Jknaebel68/Extruder/Dokumentation/Pinout_Sparkfun_Pro_Micro.jpg

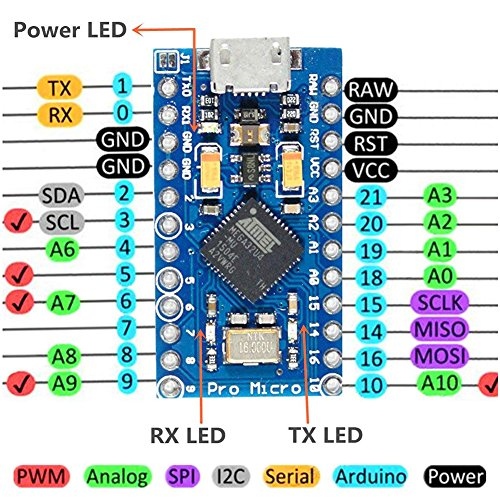
Dokumentation/Pinout_Sparkfun_Pro_Micro.jpg
