Jknaebel68/Extruder/Bilder/IMG_20191024_204414.jpg

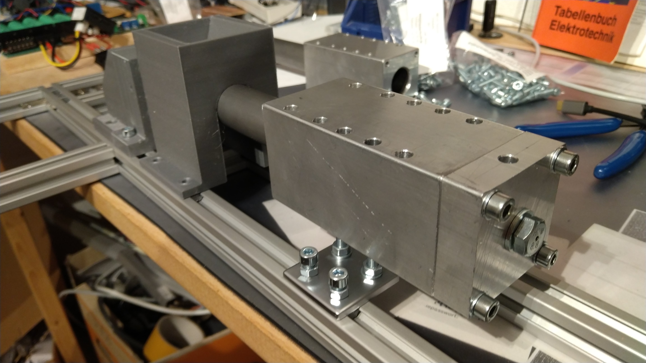
Bilder/IMG_20191024_204414.jpg
