Jknaebel68/Extruder/Steuerungsprogramm(e)/Zugmotor/Release Info Zugmotor.txt

Release Informationen zu "Zugmotorsteuerung.ino"

---------------------------------------------------------------------

v0.1
03.01.2020

Steuerung des Zugmotors über i2c
Der Zugmotor zieht am Filament um dies aus dem Extruder zu befördern.
Desweiteren kann über die Geschwindigkeitsänderung die Dicke des Filaments beeinflusst werden.
Ist der Vorschub des Zugmotors kleiner als die Extrusion, wird das Filament dicker.
Ist der Vorschub des Zugmotors größer als die Extrusion, wird das Filamend dünner.
Die Maßeinheit für den Vorschub wird in mm/min angegeben und in der Steuerung entsprechend auf die Schritte/min umgerechnet.

---------------------------------------------------------------------
