Jknaebel68/Extruder/Bilder/Bild Extruder Stand neue Kühlung 191005.jpg

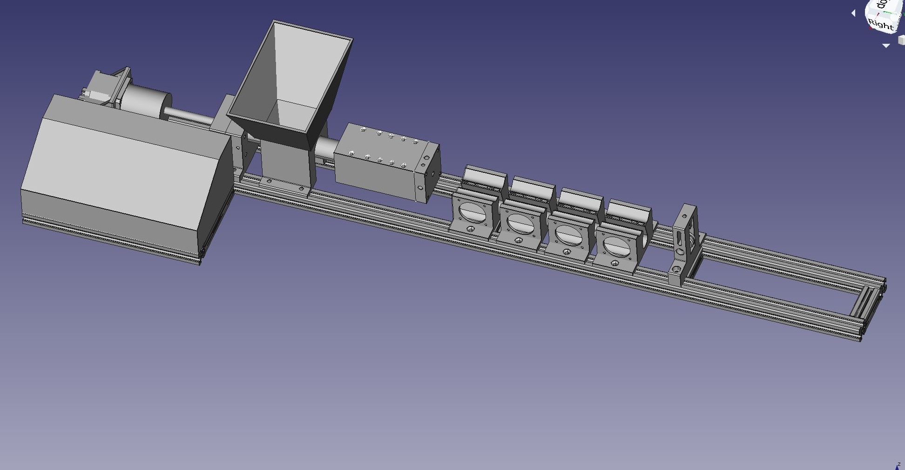
Bilder/Bild Extruder Stand neue Kühlung 191005.jpg
