Jknaebel68/Extruder/Bilder/IMG_20191008_212313.jpg

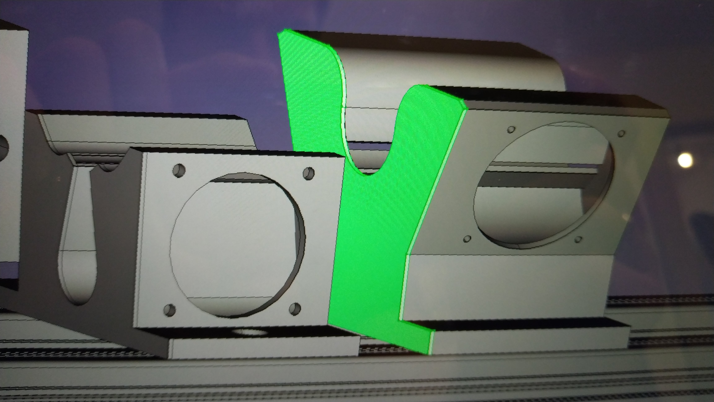
Bilder/IMG_20191008_212313.jpg
