Jknaebel68/Extruder/Bilder/IMG_20191024_204409.jpg

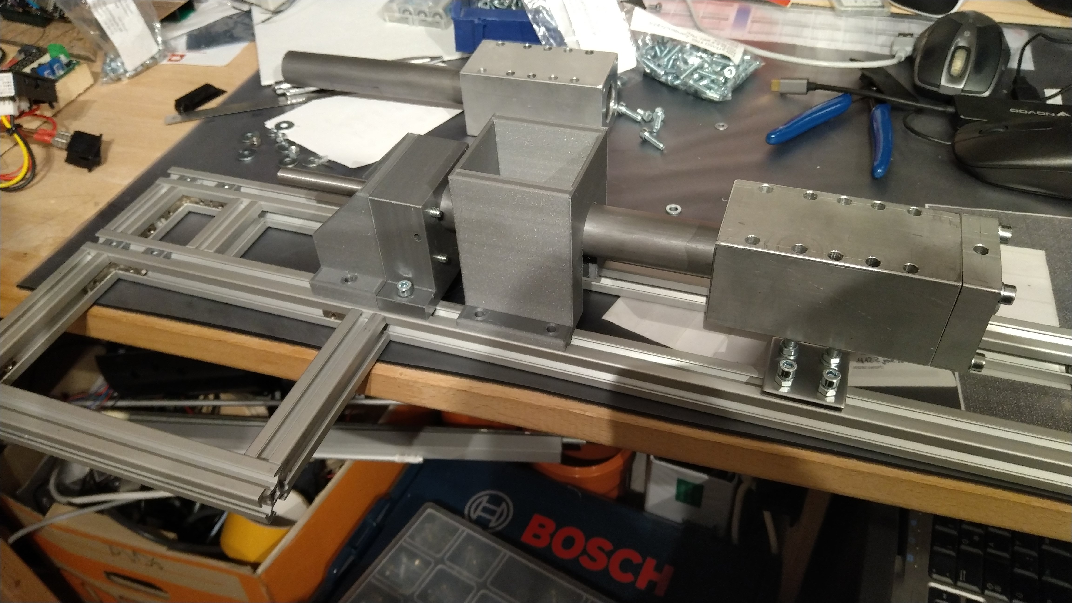
Bilder/IMG_20191024_204409.jpg
