Jknaebel68/Extruder/Bilder/IMG_20191024_204424.jpg

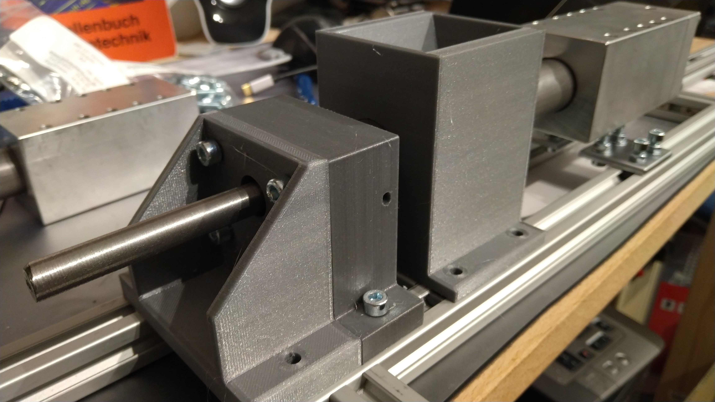
Bilder/IMG_20191024_204424.jpg
