Jknaebel68/Extruder/Bilder/IMG_20191024_204436.jpg

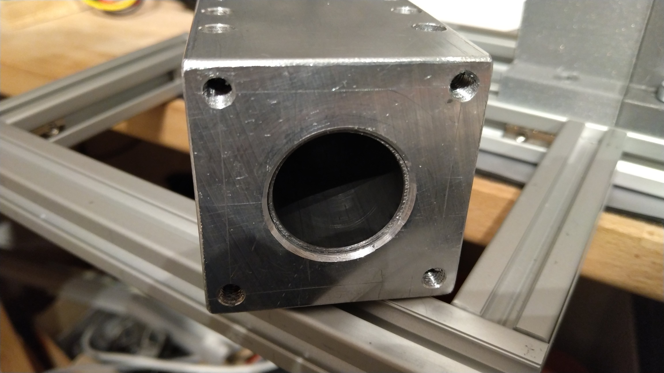
Bilder/IMG_20191024_204436.jpg
