Jknaebel68/Extruder/Bilder/IMG_20191024_204439.jpg

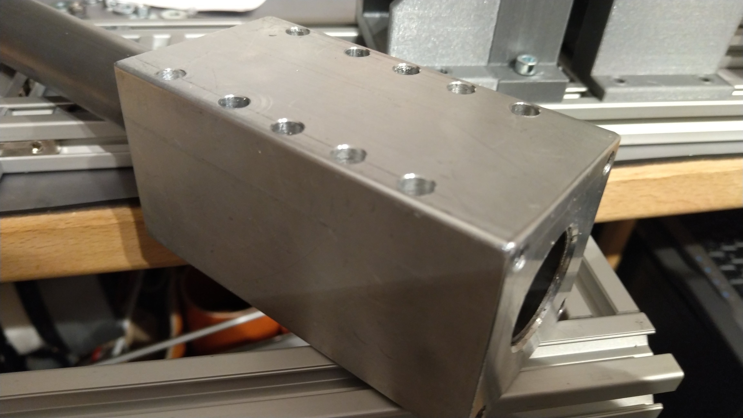
Bilder/IMG_20191024_204439.jpg
