Jknaebel68/Extruder/Bilder/IMG_20191102_174123.jpg

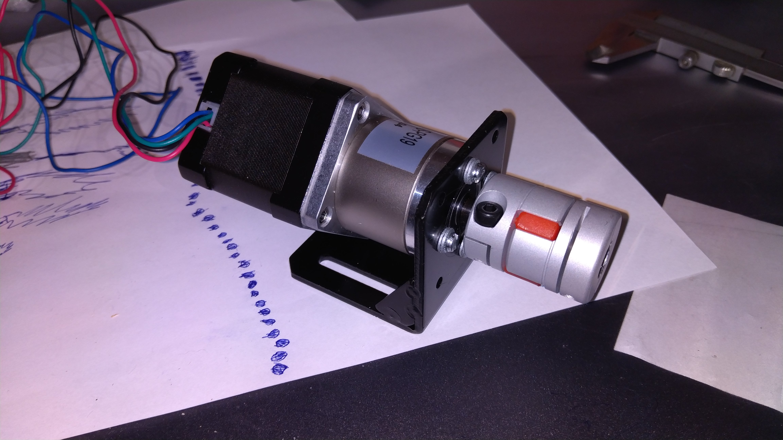
Bilder/IMG_20191102_174123.jpg
