Jknaebel68/Extruder/Bilder/IMG_20191102_174132.jpg

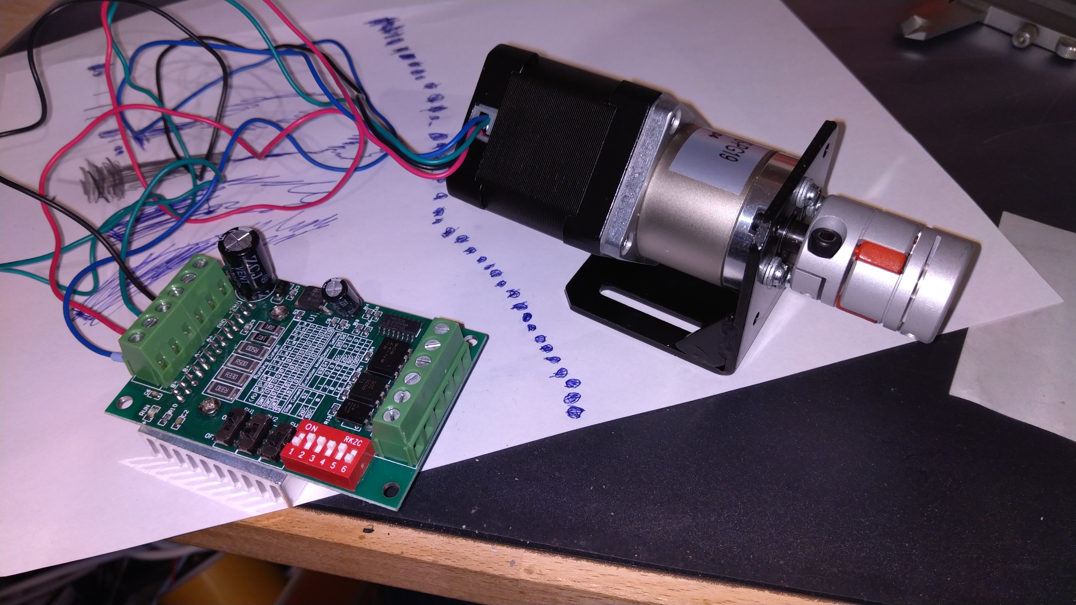
Bilder/IMG_20191102_174132.jpg
