Jknaebel68/Extruder/Dokumentation/Pinout_Arduino_Mega.png

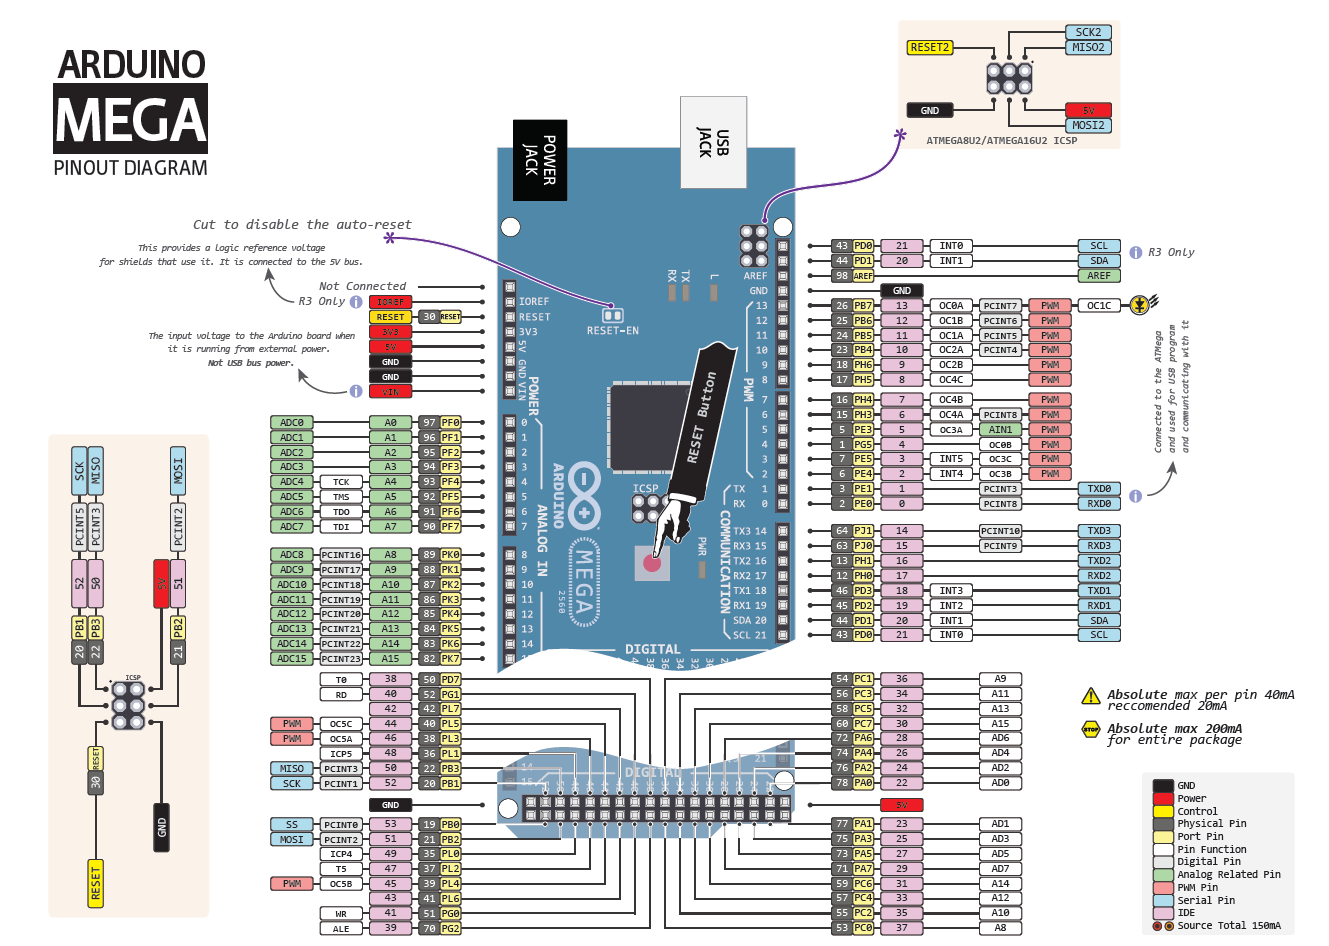
Dokumentation/Pinout_Arduino_Mega.png
