Jknaebel68/Extruder/Freecad/Distanzmotorgetriebe.stl

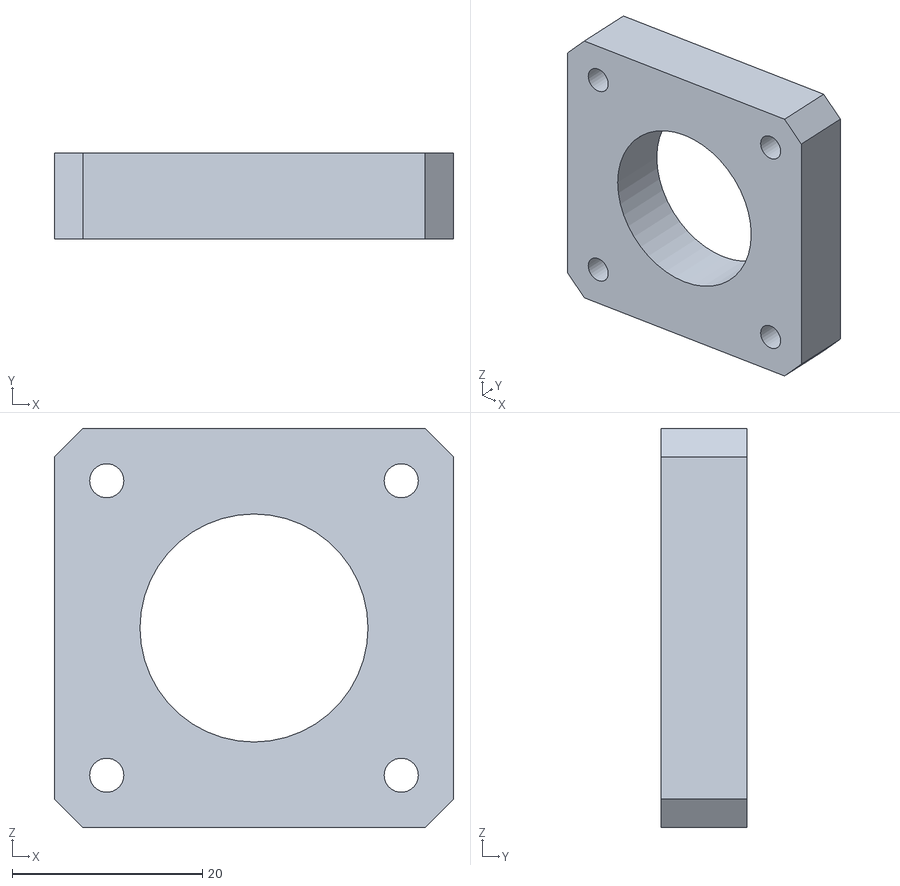
[picture p13: CAD file, 2019-12-24]
Freecad/Distanzmotorgetriebe.stl
42.0 x 9.00 x 42.0
