Jknaebel68/Extruder/Freecad/Zugeinheit.stl

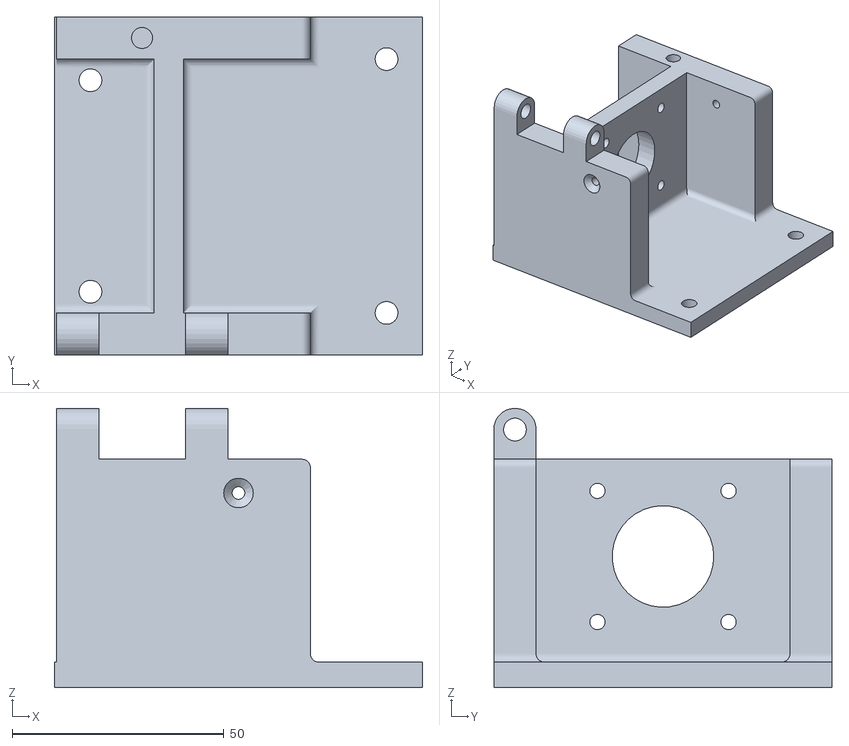
[picture p14: CAD file, 2019-12-24]
Freecad/Zugeinheit.stl
87.0 x 80.0 x 66.0
