Jknaebel68/Extruder/Freecad/Klemmhebel.stl

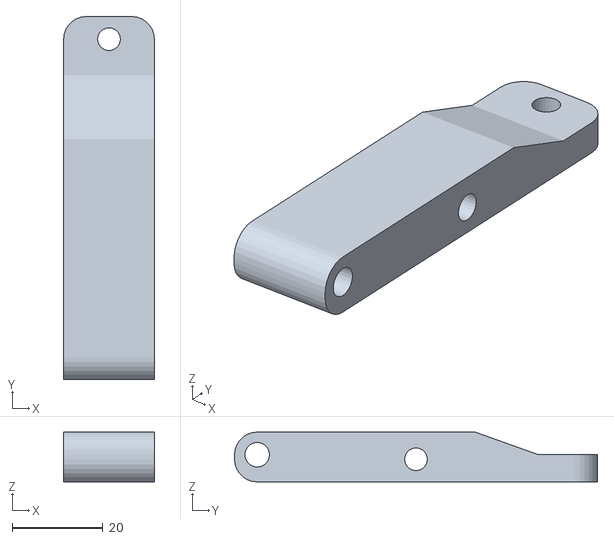
[picture p15: CAD file, 2019-12-24]
Freecad/Klemmhebel.stl
20.0 x 80.0 x 11.0
