Jknaebel68/Extruder/Freecad/Sensorhalter.stl

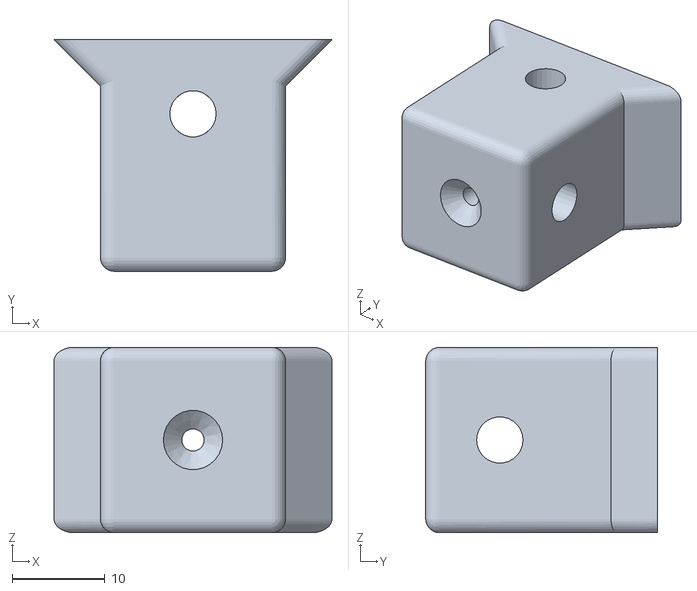
[picture p16: CAD file, 2019-12-24]
Freecad/Sensorhalter.stl
30.0 x 25.0 x 20.0
