Jknaebel68/Extruder/Freecad/Zugrolle.stl

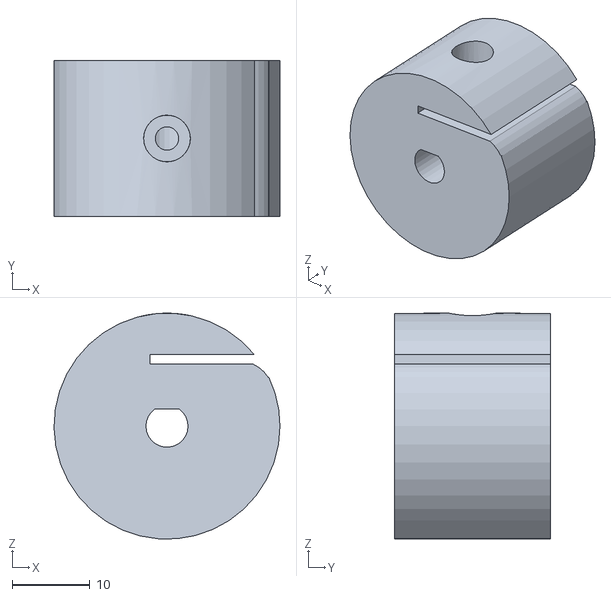
[picture p17: CAD file, 2019-12-24]
Freecad/Zugrolle.stl
29.0 x 20.0 x 29.0
