Jknaebel68/Extruder/Freecad/Anpressrolle.stl

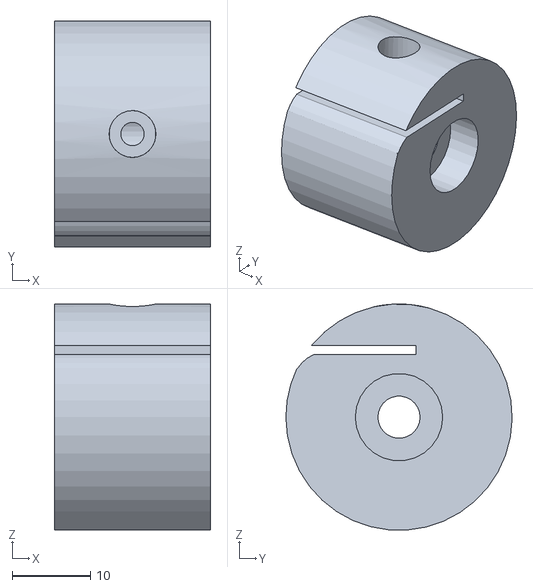
[picture p18: CAD file, 2019-12-24]
Freecad/Anpressrolle.stl
20.0 x 29.0 x 29.0
