Jknaebel68/Extruder/Freecad/Anpressschlitten.stl

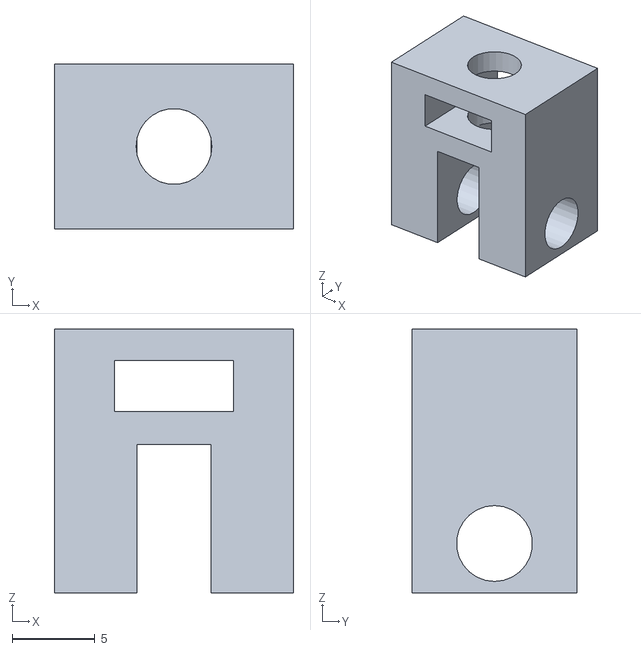
[picture p19: CAD file, 2019-12-24]
Freecad/Anpressschlitten.stl
14.5 x 10.0 x 16.0
