Jknaebel68/Extruder/Freecad/ExtrudereinheitV2git.FCStd

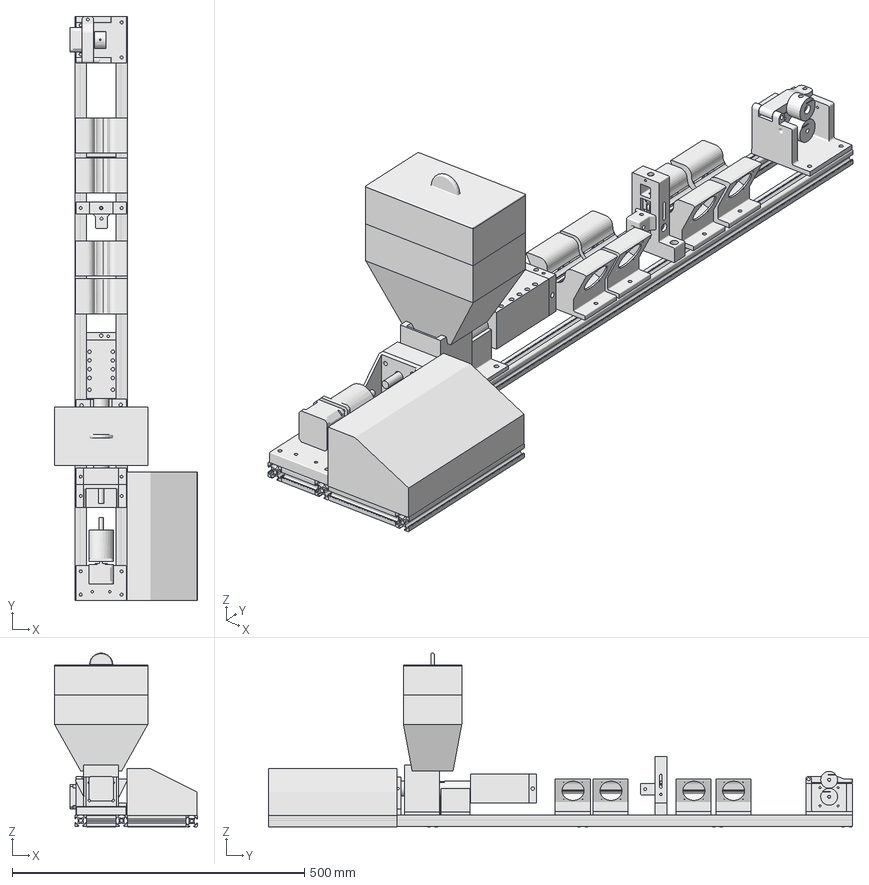
[picture p20: CAD file, 2019-12-24]
Freecad/ExtrudereinheitV2git.FCStd
245.0 x 1000.0 x 297.4 mm
Extrudermantel
Düsenplatte
Heizblock
Axiallager
Einfüllstutzen
Vorratsbehälter
Extruderschnecke
Aluprofil20x20x50_1
Aluprofil20x20x50_002
Aluprofil20x20x50_003
Aluprofil20x20x50_004
Aluprofil20x20x50_005
Getriebe
Kugellagerbock
Führungsbock
Anpressschlitten
Filamentführung
Anpresslager
P20_N6_B002
Aluprofil20x20x50_006
P20_N6_B001
Aluprofil20x20x101
Aluprofil20x20x102
Aluprofil20x20x103
Kühlelement1
Kühlelement002
Kühlelement003
Kühlelement004
Motorsockel
ErweiterungVorrat001
ErweiterungVorrat002
Deckel
Mantelhalter001
Mantelhalter002
Zugeinheit
Klemmhebel
Sensorhalter
Zugrolle
Zugrolle001
Motor_NEMA17
Motor_NEMA018
