Jknaebel68/Extruder/Freecad/Lagerabdeckstütze.stl

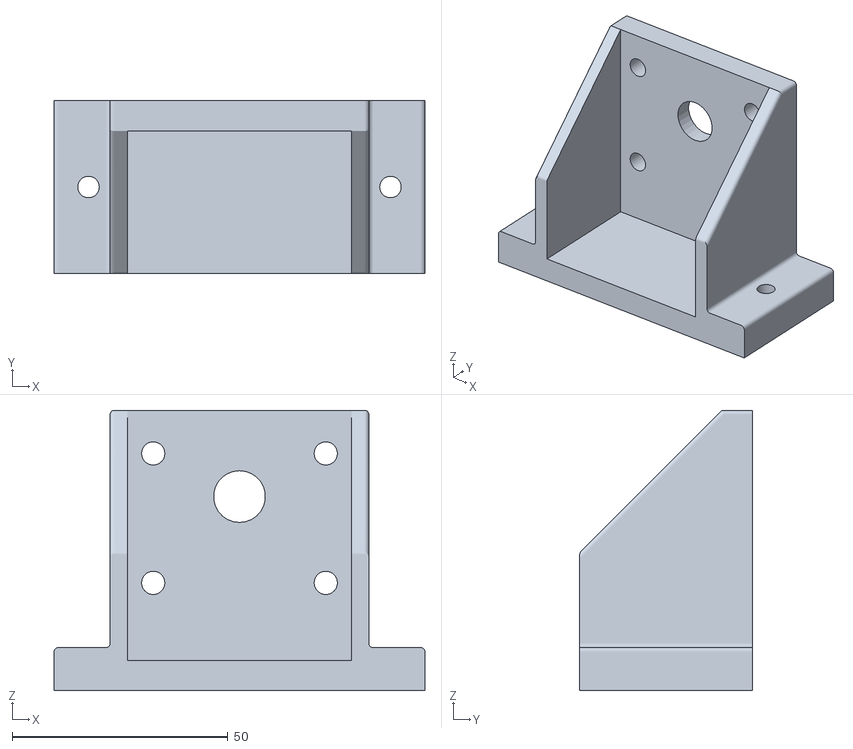
[picture p21: CAD file, 2019-12-01]
Freecad/Lagerabdeckstütze.stl
86.0 x 40.0 x 65.0
