Jknaebel68/Extruder/Freecad/Motorsockel.stl

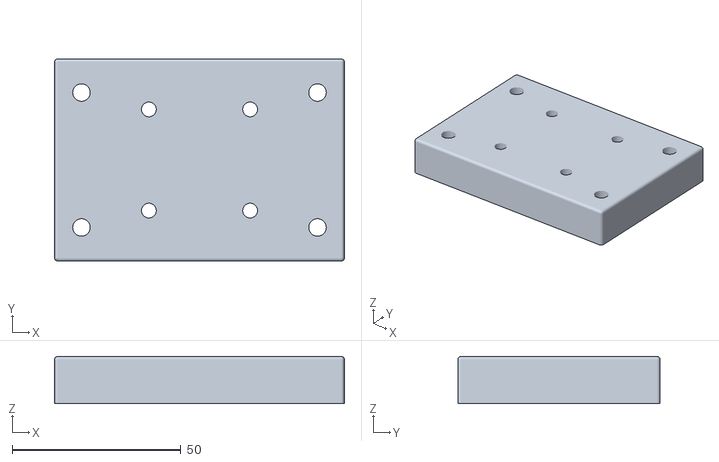
[picture p22: CAD file, 2019-12-01]
Freecad/Motorsockel.stl
86.0 x 60.0 x 14.0
