Jknaebel68/Extruder/Freecad/Einfuellstutzen.stl

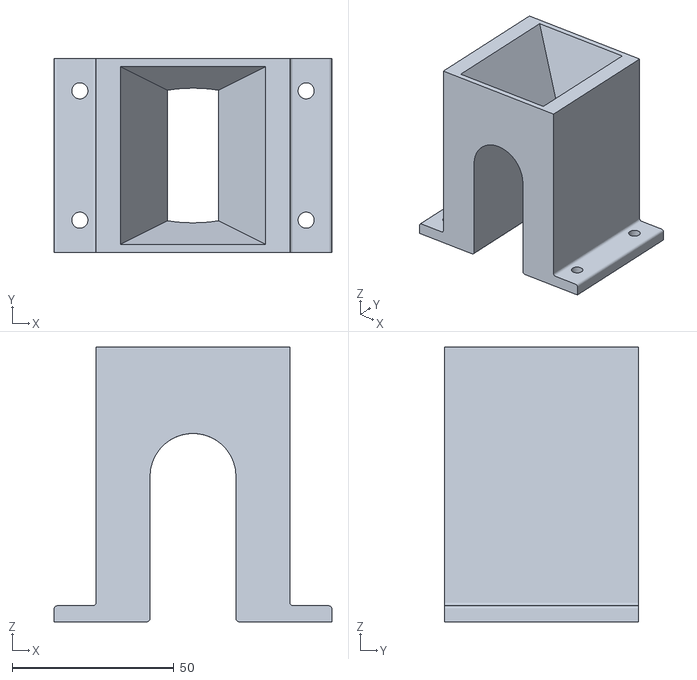
[picture p23: CAD file, 2019-12-01]
Freecad/Einfuellstutzen.stl
86.0 x 60.0 x 85.0
