Jknaebel68/Extruder/Freecad/Vorratsbehälter.stl

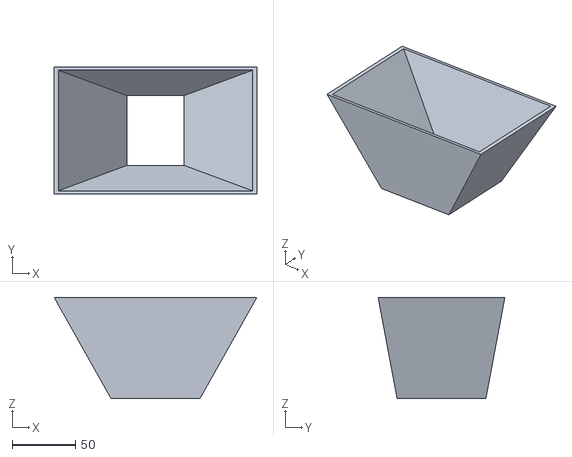
[picture p24: CAD file, 2019-12-01]
Freecad/Vorratsbehälter.stl
160.0 x 100.0 x 80.0
