Jknaebel68/Extruder/Freecad/Kühlstrecke2v2.stl

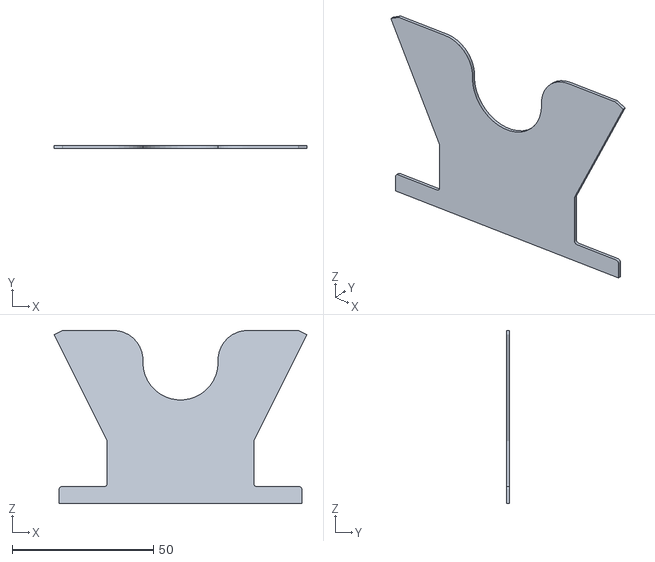
[picture p25: CAD file, 2019-12-01]
Freecad/Kühlstrecke2v2.stl
89.6 x 1.00 x 61.3
