Jknaebel68/Extruder/Freecad/ErweiterungVorrat.stl

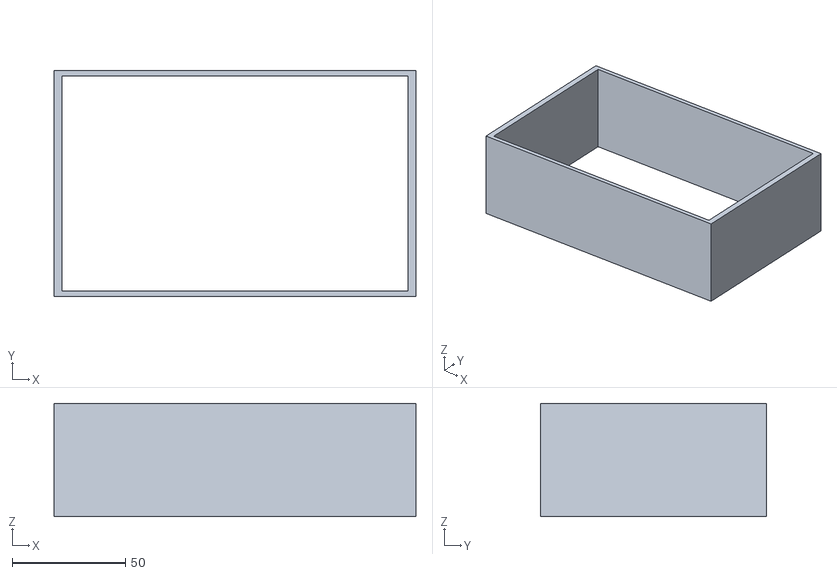
[picture p26: CAD file, 2019-12-01]
Freecad/ErweiterungVorrat.stl
160.0 x 100.0 x 50.0
