Jknaebel68/Extruder/Freecad/Kühlstrecke1v2.stl

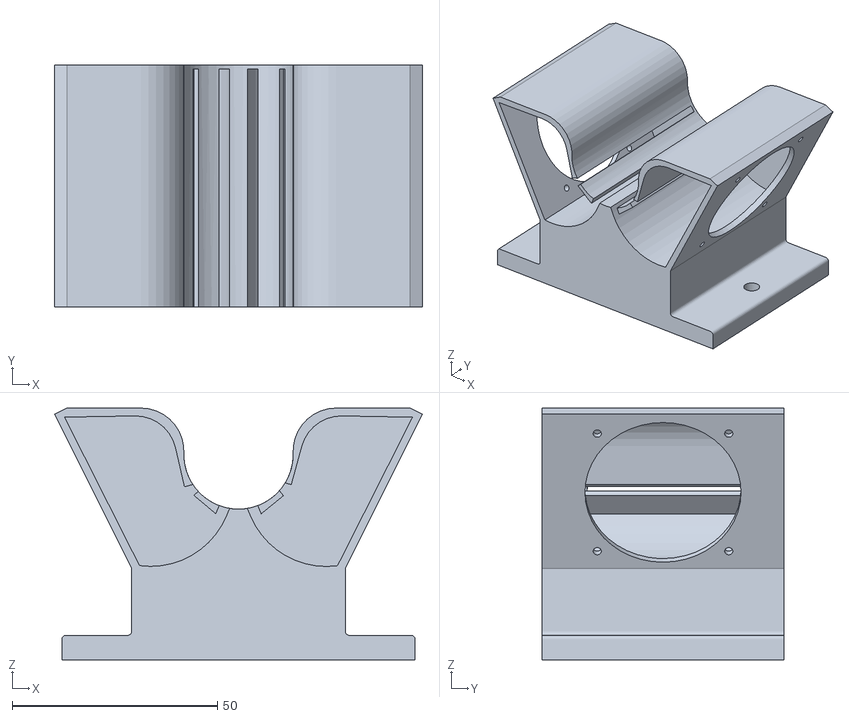
[picture p27: CAD file, 2019-12-01]
Freecad/Kühlstrecke1v2.stl
89.6 x 59.0 x 61.3
