Jknaebel68/Extruder/Freecad/Deckel.stl

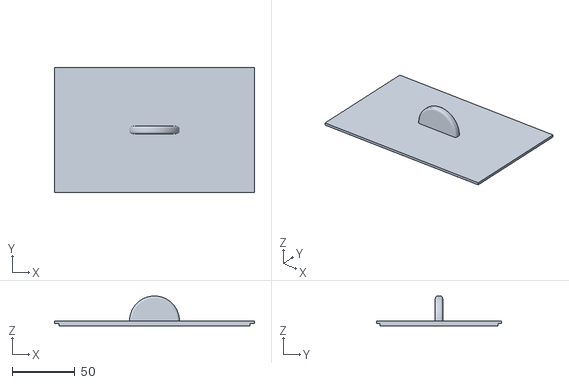
[picture p28: CAD file, 2019-12-01]
Freecad/Deckel.stl
160.0 x 100.0 x 24.0
