Jknaebel68/Extruder/Freecad/Schrägsitzlagerbock.stl

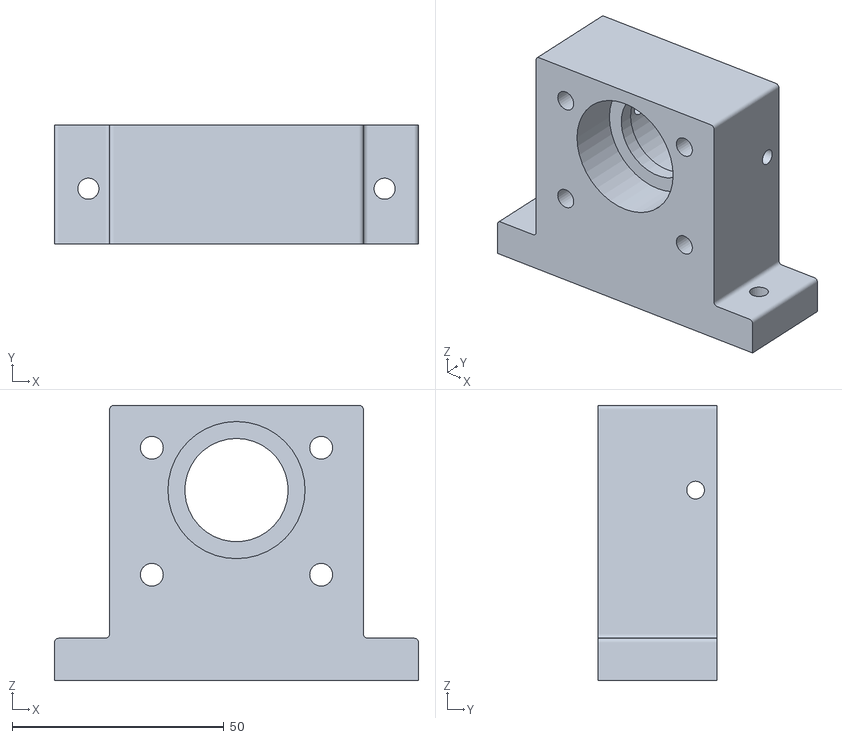
[picture p29: CAD file, 2019-12-01]
Freecad/Schrägsitzlagerbock.stl
86.0 x 28.0 x 65.0
