Jknaebel68/Extruder/Dokumentation/Datenblatt_Stepper.pdf

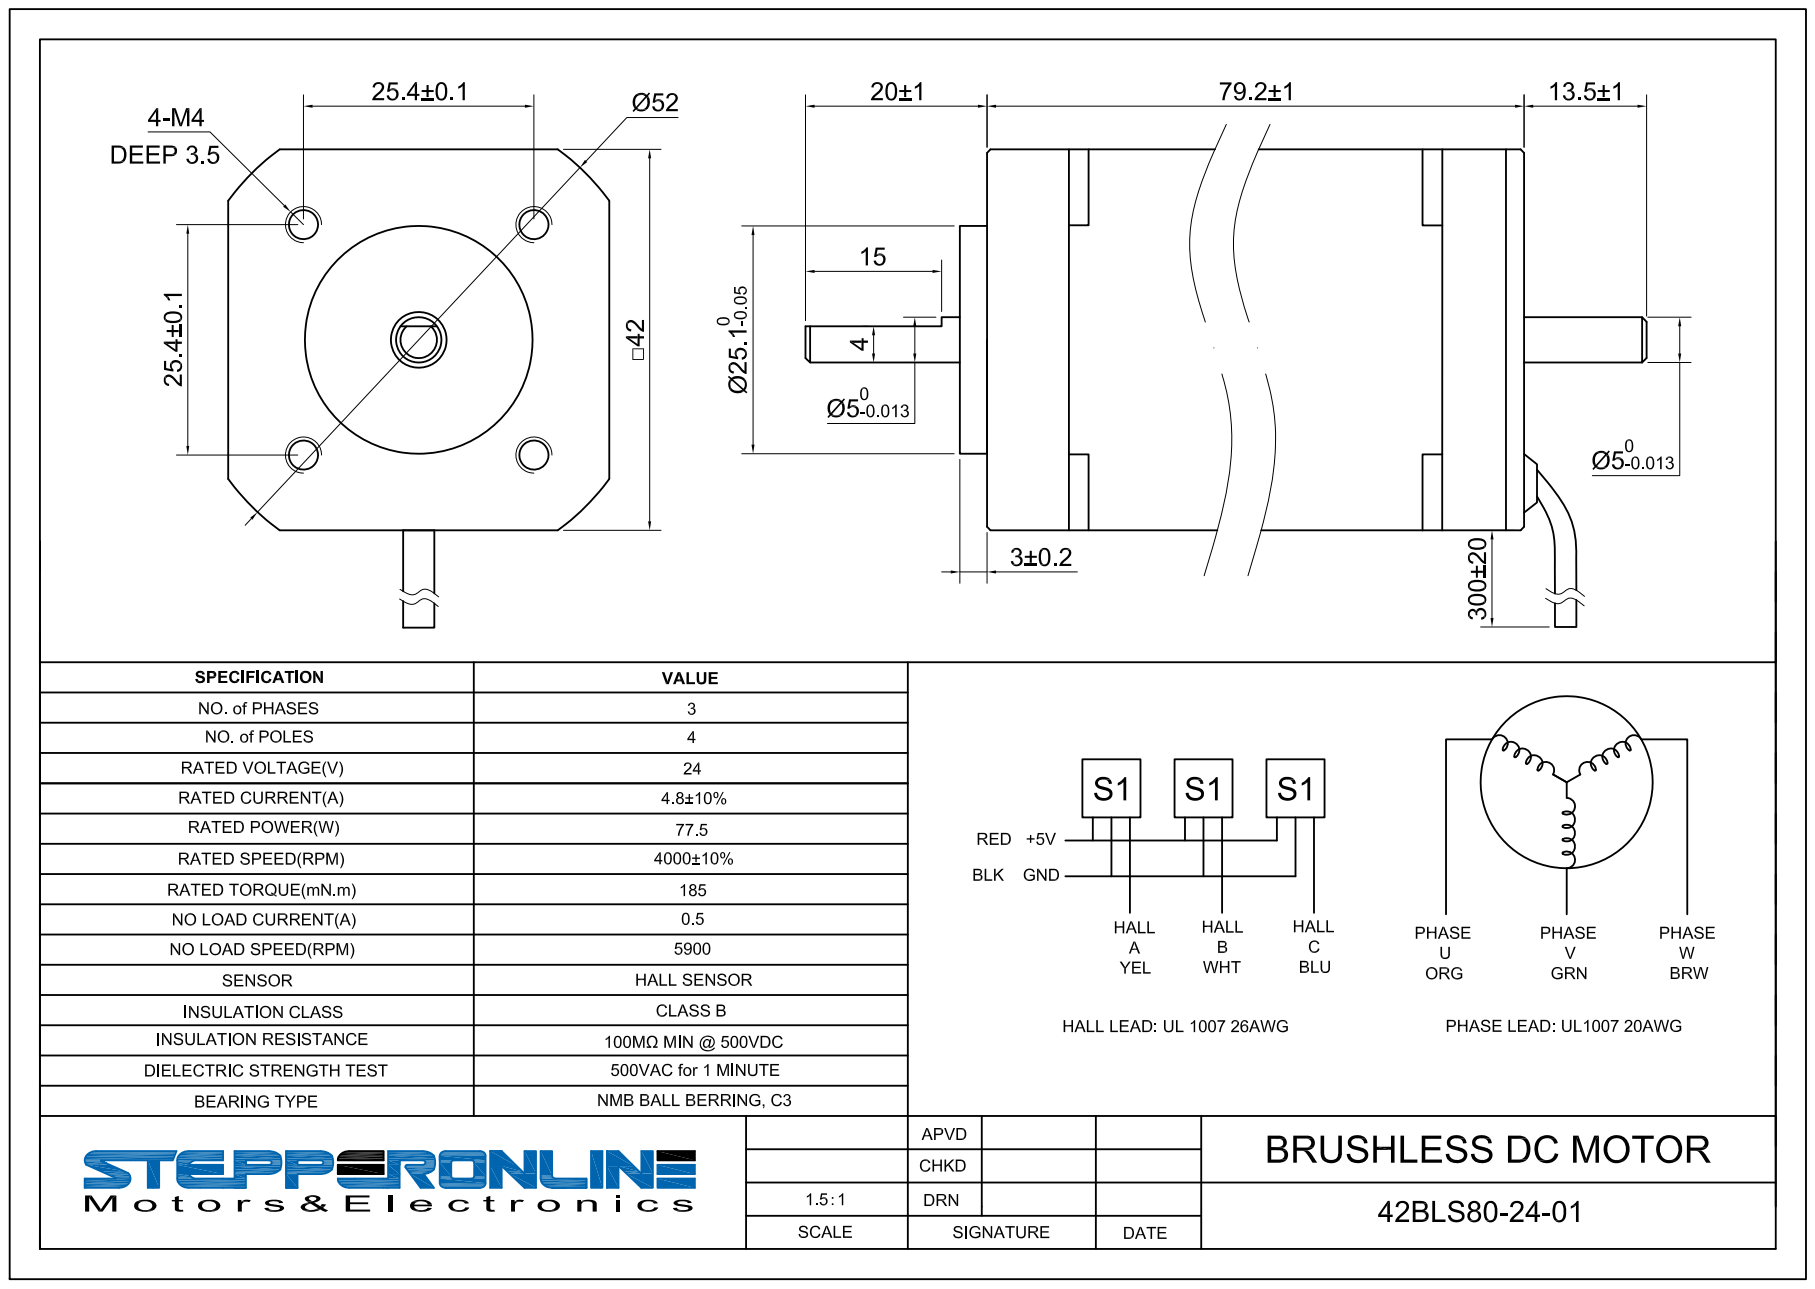
[picture p30: page 1]
