Jknaebel68/Extruder/Dokumentation/Datenblatt_Haltewinkel_NEMA23.pdf

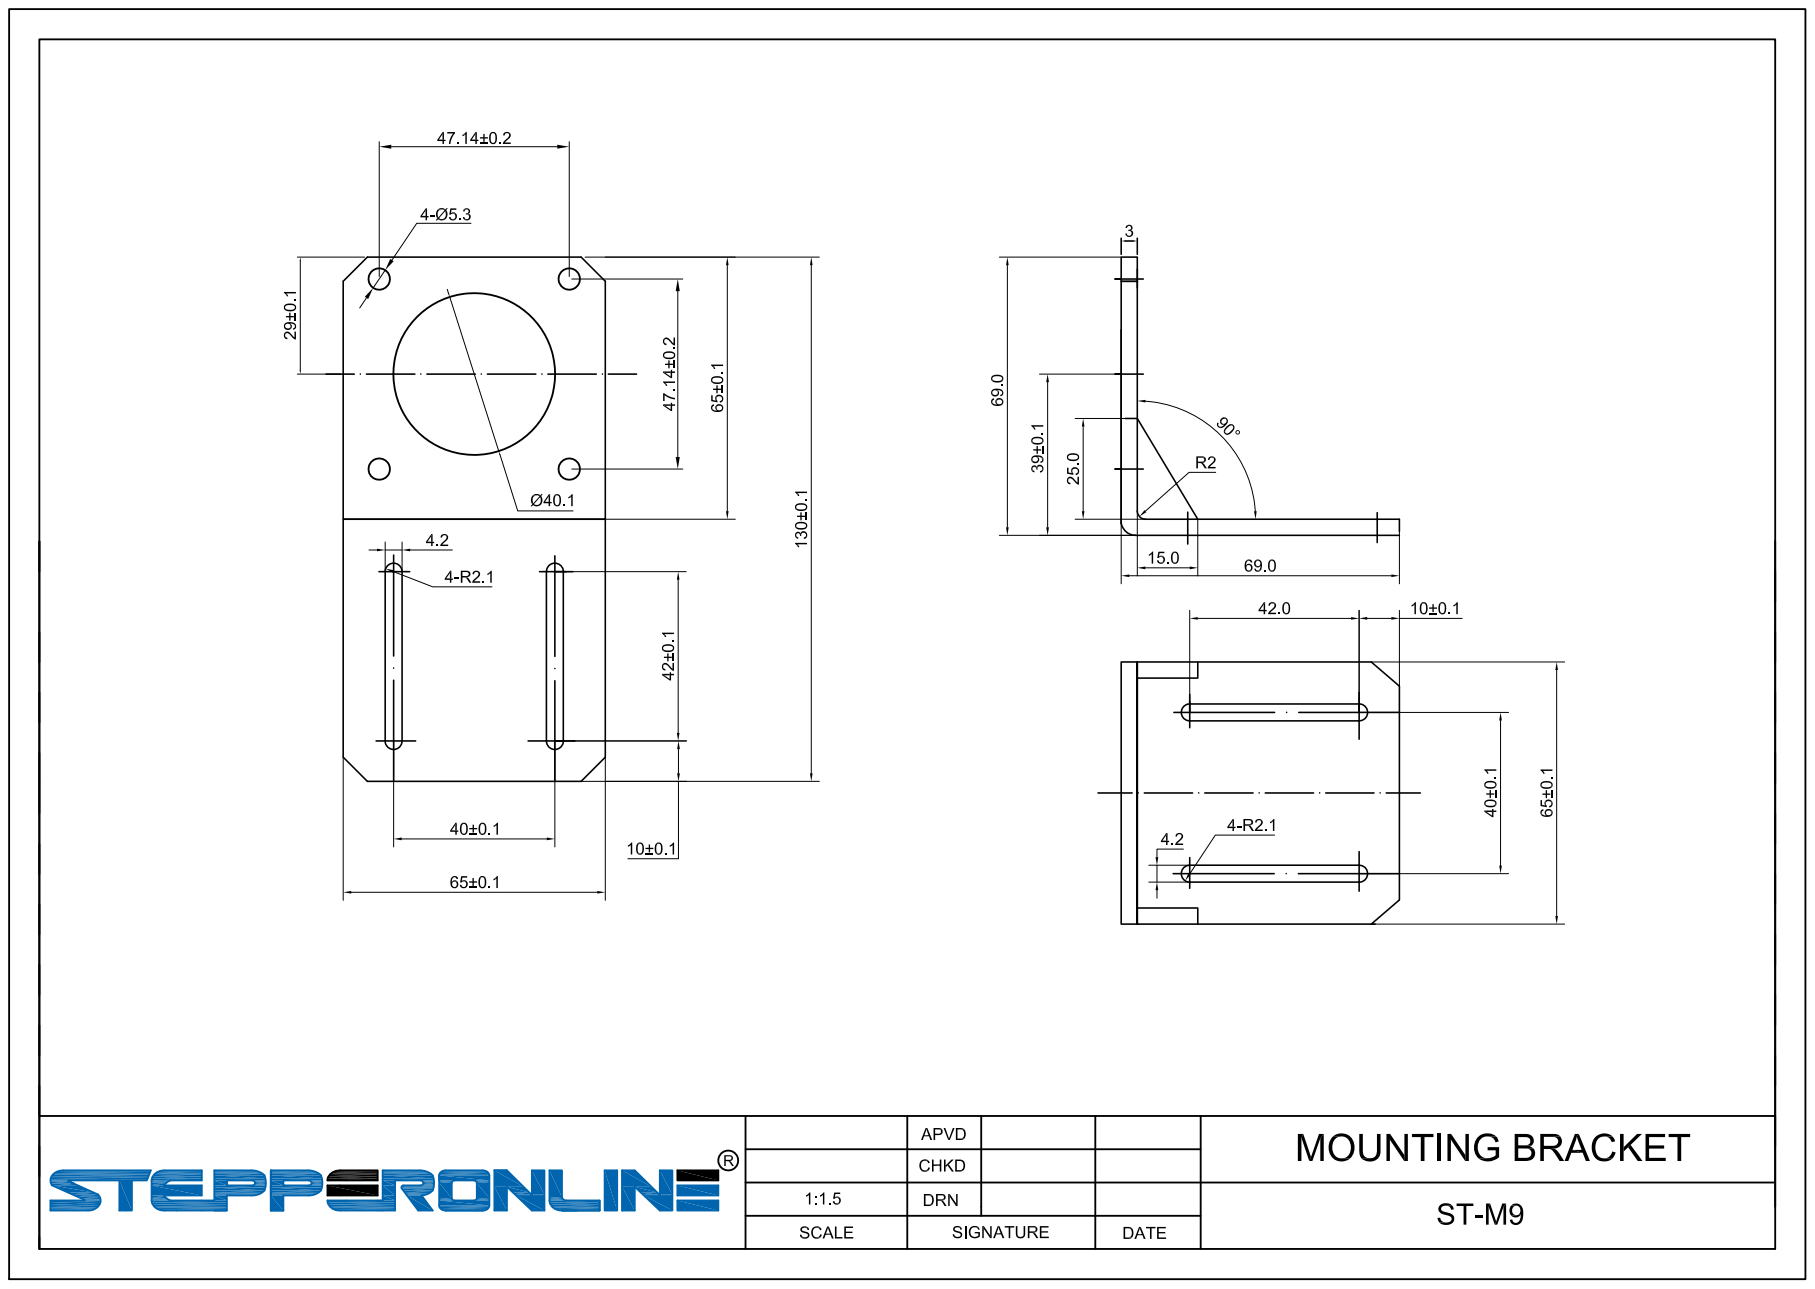
[picture p31: page 1]
