Jknaebel68/Extruder/(commit log)

2019-11-21 PID eingefügt
    [ExtrudereinheitV2 (2).FCStd]
2019-11-21 PID Regelung erstellt
2019-11-25 Code aufgeräumt und umsortiert
2019-11-27 Update and rename Extrudersteuerung_v0.6.ino to Extrudersteuerung_v0.7.ino
2019-11-28 Update Extruder HMI_v0.2.txt
2019-11-29 Update and rename Extruder HMI_v0.2.txt to Release Information HMI.txt
2019-12-15 Zugeinheit und Filamentsensor hinzugefügt
    Filamentsensor auf Basis von 2 LDR und 2 5mm LED
    [ExtrudereinheitV2git.FCStd]
2019-12-23 Create Extrudersteuerung_v0.9.ino
    Strommessung Heizung und Extrudermotor eingefügt.
2019-12-23 Update Extrudersteuerung_Releases.txt
    Anmerkungen v0.9
2019-12-24 Add files via upload
    Extruder mit Zugeinheit
    [ExtrudereinheitV2git.FCStd]
2019-12-30 Rücklauf bei Alarm des Servo eingefügt
2019-12-30 Update Rücklauf Servo
2020-01-01 Reduzierung Stromanzeige und Vorarbeit Zugmotor
2020-01-01 Anpassung Zugmotor und Stromanzeige
2020-01-02 Fehlerkorrektur beim Deklarieren der Buttons
2020-01-02 neue Buttons Zugeinheit
2020-01-08 Hz-Regelung auf PWM umgestellt
2020-01-12 Benennung von Buttons und Textfeldern optimiert
2020-01-12 PID Regler optimiert
